koala3005/ESP32Clone_With_I2C_Sensor/24LC1025-I_SM/24LC1025-I_SM.step

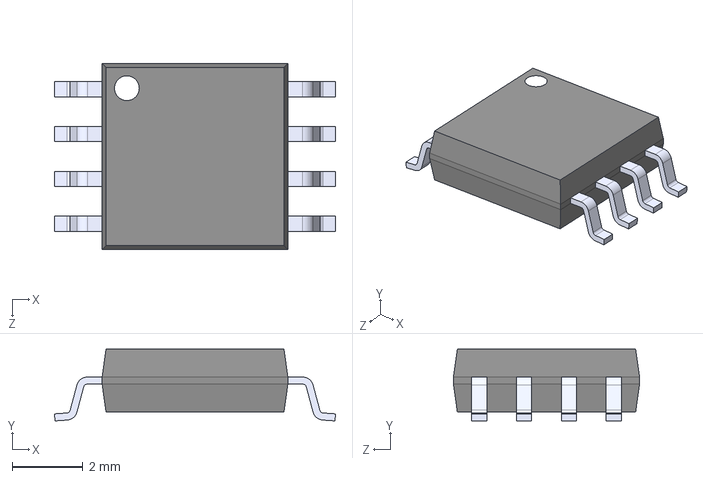
[picture p1: CAD file, 2026-01-12]
24LC1025-I_SM/24LC1025-I_SM.step
7.94 x 2.03 x 5.26 mm
