koala3005/ESP32Clone_With_I2C_Sensor/AHT20/AHT20.step

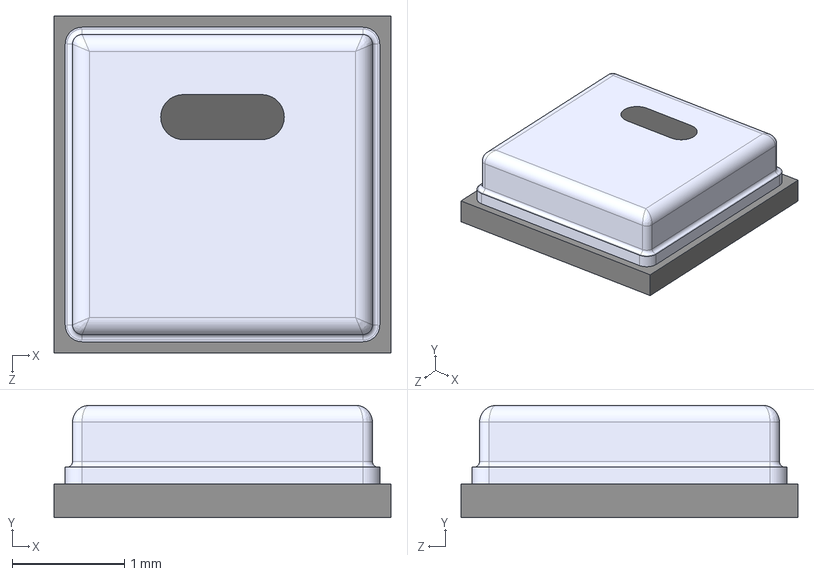
[picture p2: CAD file, 2026-01-12]
AHT20/AHT20.step
3.00 x 1.00 x 3.00 mm
