koala3005/ESP32Clone_With_I2C_Sensor/BH1750FVI-TR/BH1750FVI-TR.step

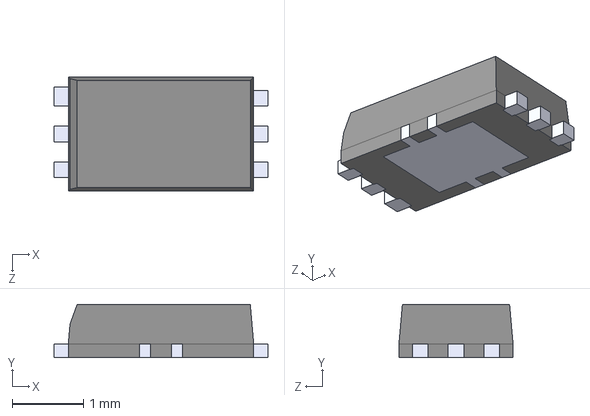
[picture p3: CAD file, 2026-01-12]
BH1750FVI-TR/BH1750FVI-TR.step
3.00 x 0.75 x 1.60 mm
