koala3005/ESP32Clone_With_I2C_Sensor/JLCPCBExtended/SRP4020TA-4R7M.step

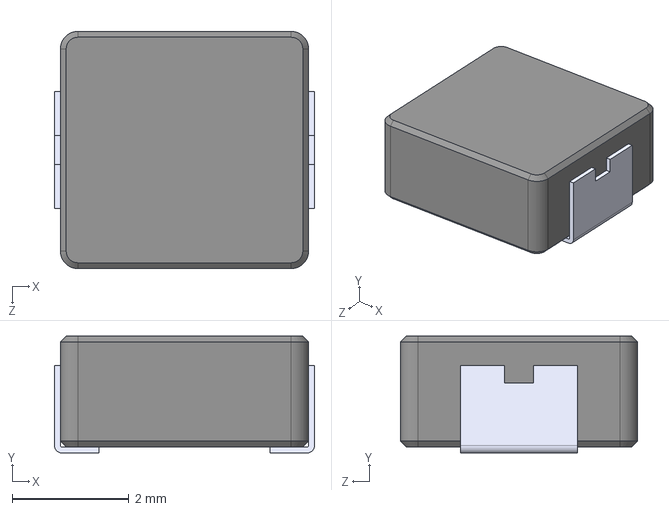
[picture p4: CAD file, 2025-12-17]
JLCPCBExtended/SRP4020TA-4R7M.step
4.45 x 2.00 x 4.06 mm
