koala3005/ESP32Clone_With_I2C_Sensor/JLCPCBExtended/MAL214699103E3.step

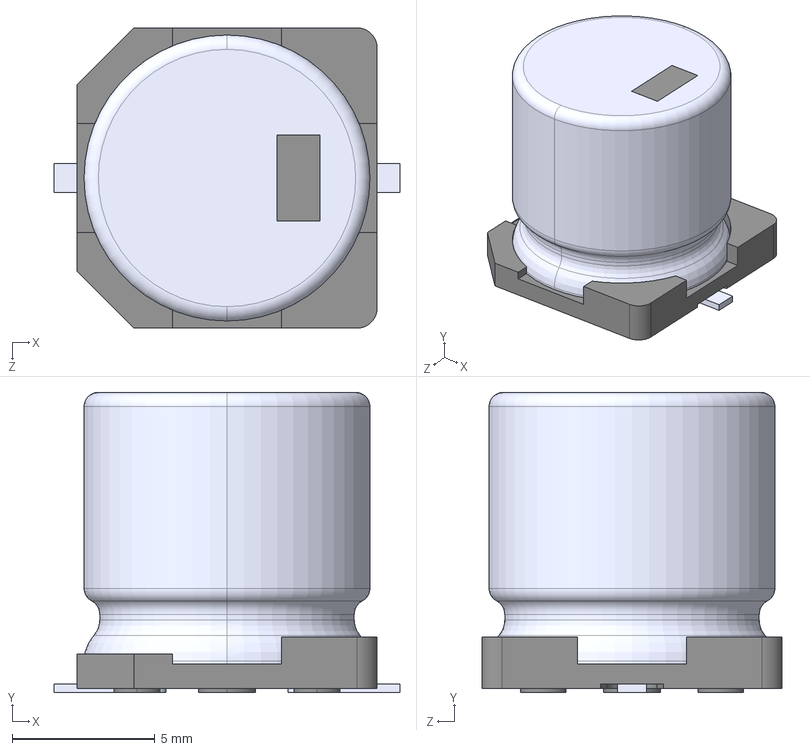
[picture p5: CAD file, 2025-12-17]
JLCPCBExtended/MAL214699103E3.step
12.1 x 10.5 x 10.5 mm
