koala3005/ESP32Clone_With_I2C_Sensor/ESP32Clone/ESP32Clone.kicad_pcb

## KiCad design ESP32Clone/ESP32Clone.kicad_pcb (2026-01-16)

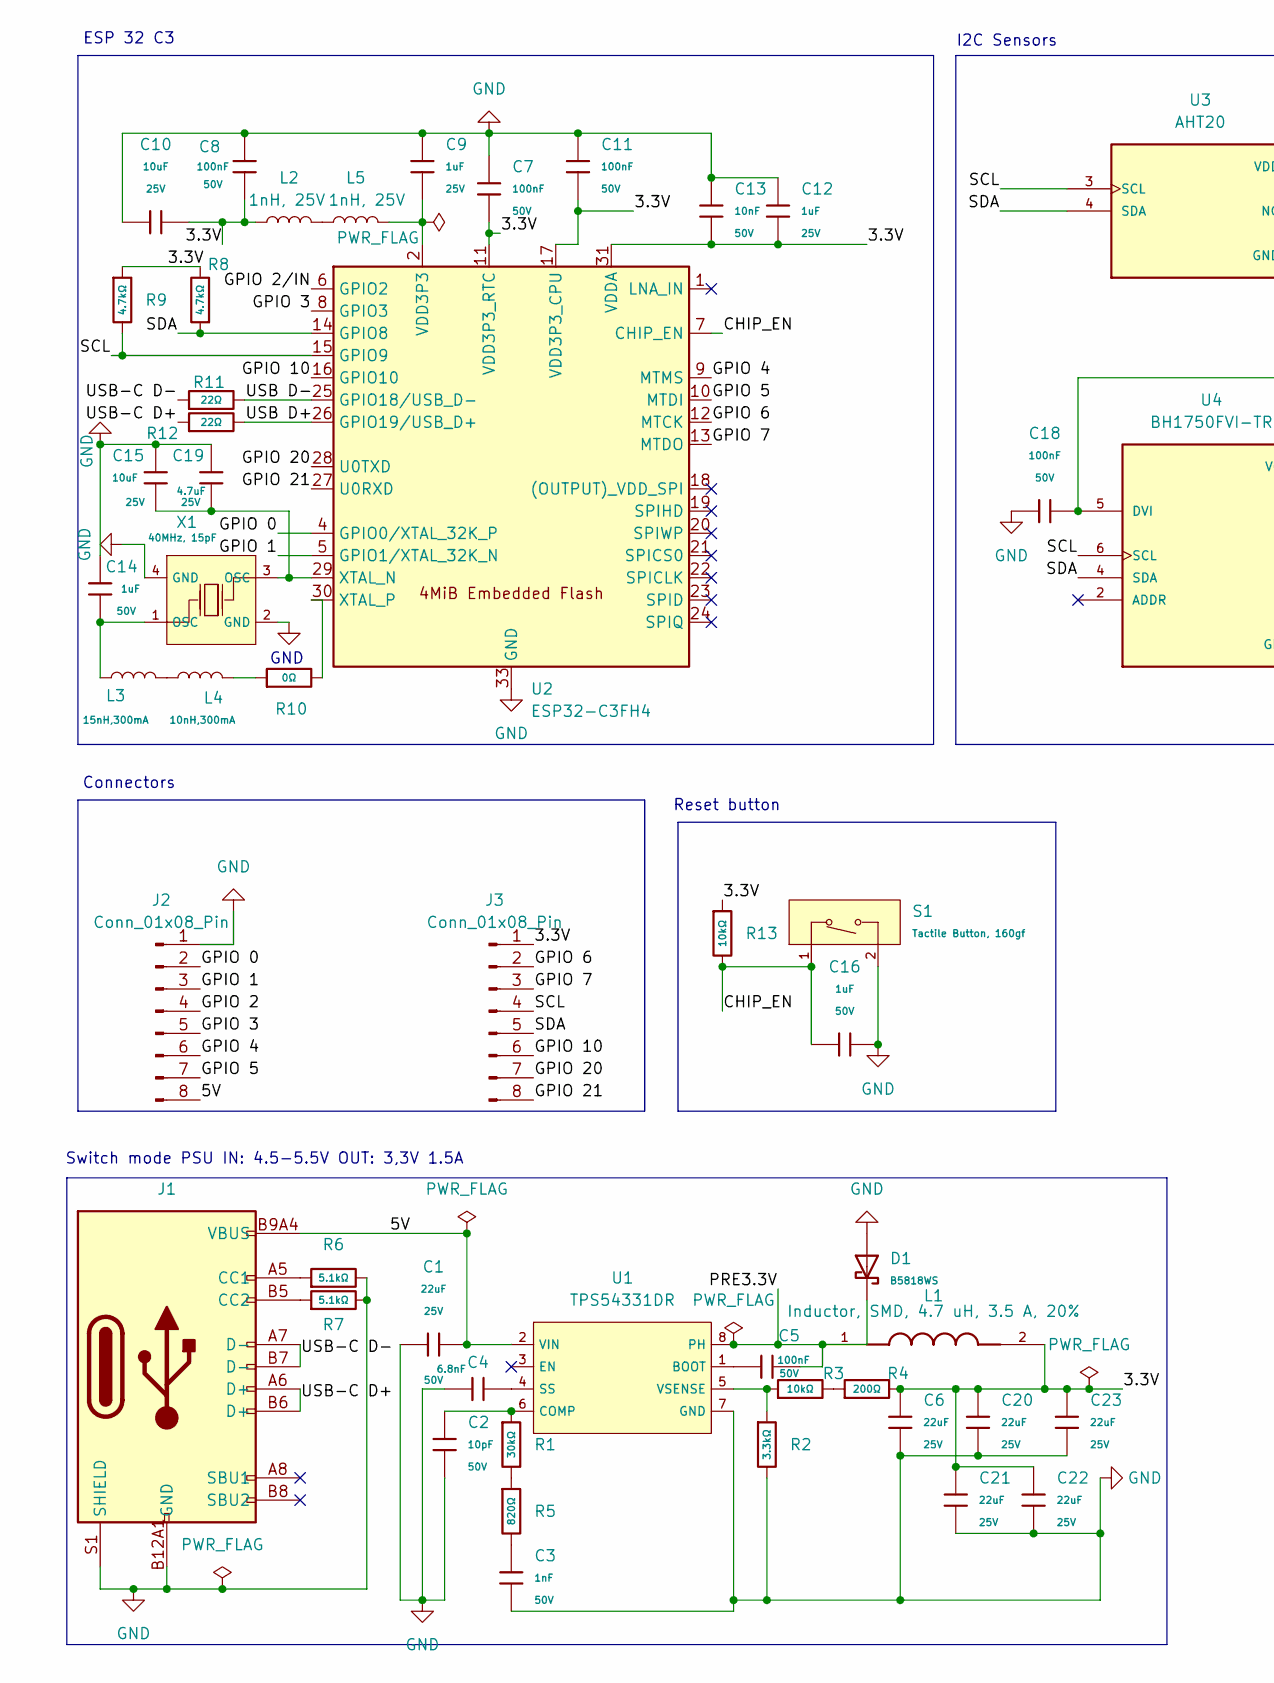
[picture p6: schematic ESP32Clone.kicad_sch, ESP32 clone with I2C humidity, light sensor and eeprom, part in row 1, column 1]

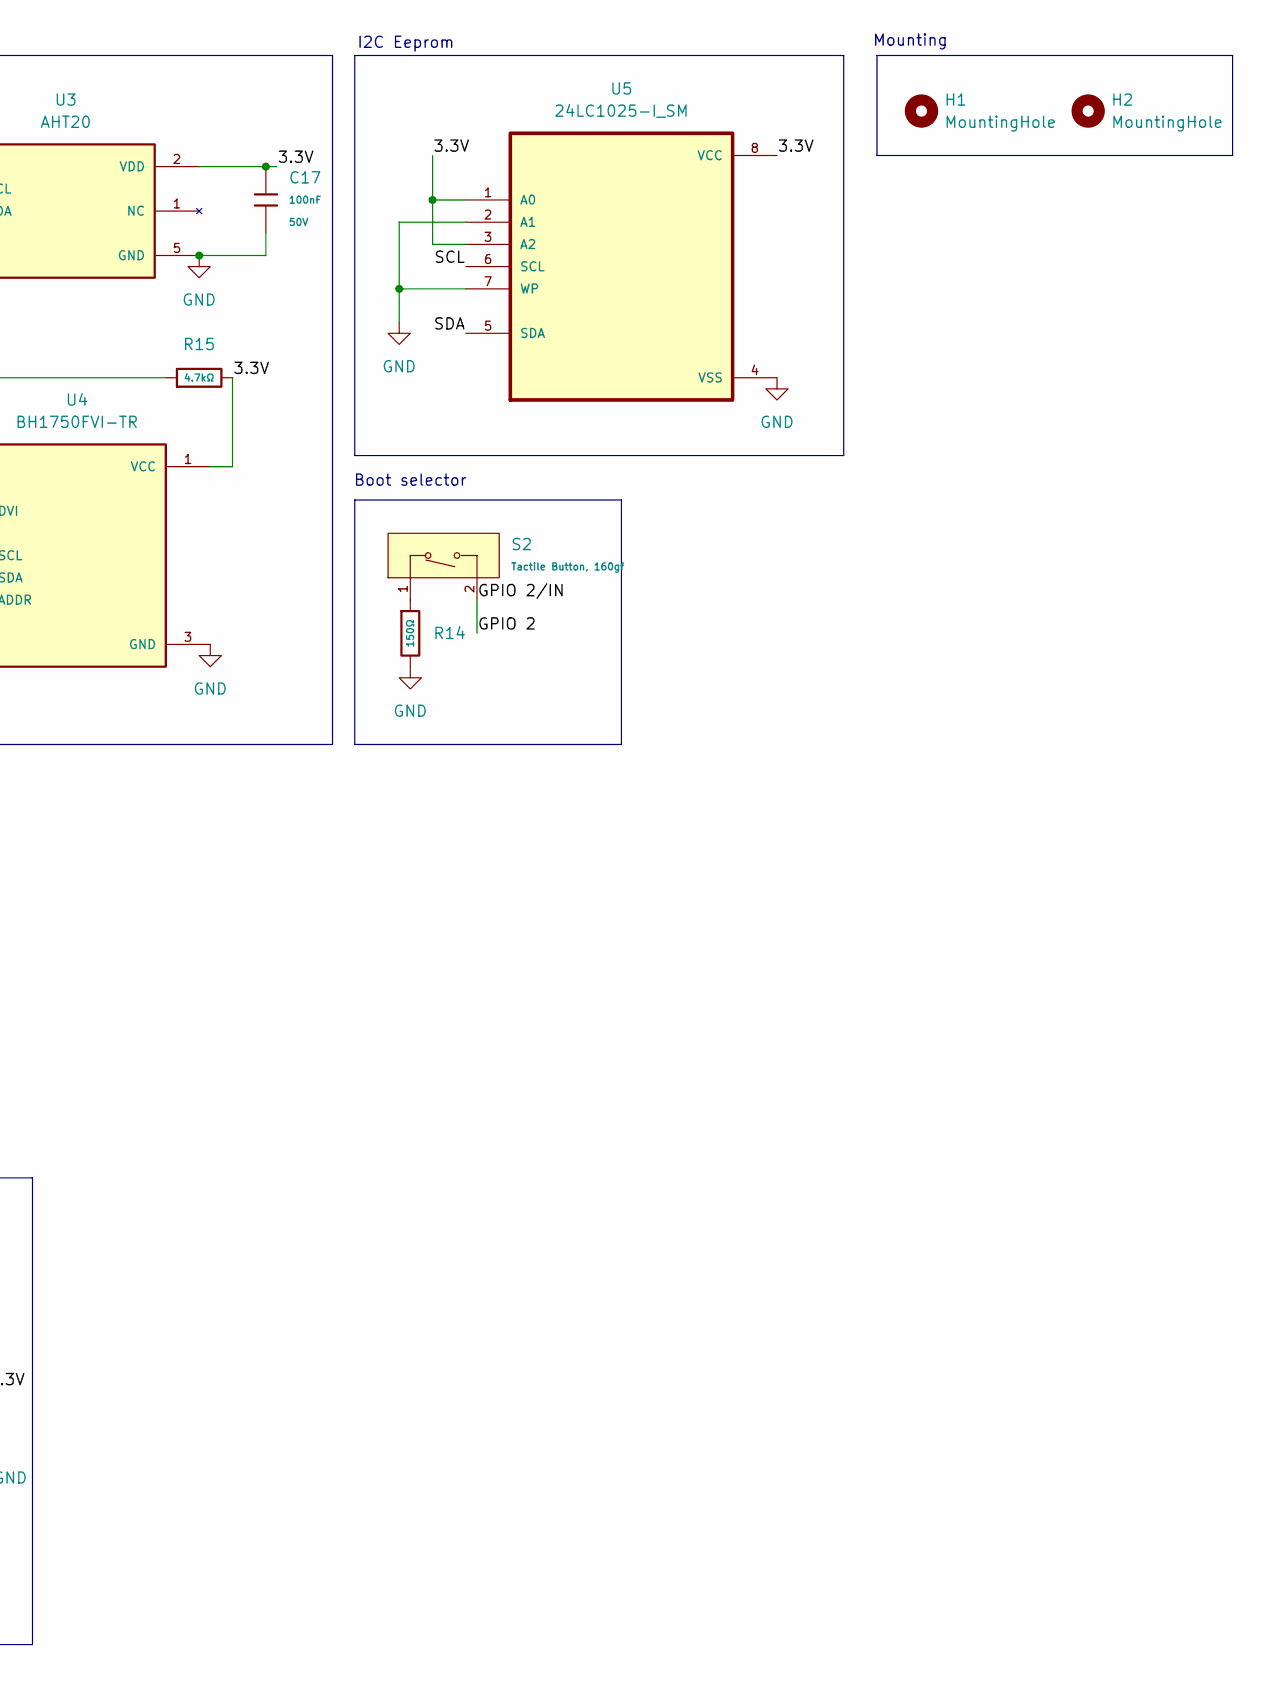
[picture p7: schematic ESP32Clone.kicad_sch, ESP32 clone with I2C humidity, light sensor and eeprom, part in row 1, column 2]

Parts:
C1, C6, C20, C21, C22, C23: 22uF; C_0805; Voltage Rated 25V; Tolerance ±20%; Part CL21A226MAQNNNE; LCSC C45783
C2: 10pF; C_0402; Voltage Rated 50V; Tolerance ±5%; Part CL05C100JB5NNNC; LCSC C32949
C3: 1nF; C_0402; Voltage Rated 50V; Tolerance ±10%; Part 0402B102K500NT; LCSC C1523
C4: 6.8nF; C_0402; Voltage Rated 50V; Tolerance ±10%; Part 0402B682K500NT; LCSC C1542
C5, C7, C8, C11, C17, C18: 100nF; C_0603; Voltage Rated 50V; Tolerance ±10%; Part CC0603KRX7R9BB104; LCSC C14663
C9, C12: 1uF; C_0402; Voltage Rated 25V; Tolerance ±10%; Part CL05A105KA5NQNC; LCSC C52923
C10, C15: 10uF; C_0603; Voltage Rated 25V; Tolerance ±20%; Part CL10A106MA8NRNC; LCSC C96446
C13: 10nF; C_0402; Voltage Rated 50V; Tolerance ±10%; Part CL05B103KB5NNNC; LCSC C15195
C14, C16: 1uF; C_0603; Voltage Rated 50V; Tolerance ±10%; Part CL10A105KB8NNNC; LCSC C15849
C19: 4.7uF; C_0805; Voltage Rated 25V; Tolerance ±10%; Part CL21A475KAQNNNE; LCSC C1779
D1: B5818WS; D_SOD-323; Forward Voltage (Vf@If) 550mV@1A; Reverse Voltage (Vr) 30V; Part B5818WS; LCSC C22466361
H1, H2: MountingHole; MountingHole_2.1mm
J1: Connector, USB-TYPE-C-16P; TYPE-C-SMD_HX-TYPE-C-16PIN; Part USB-TYPE-C-019; LCSC C2927039
J2, J3: Conn_01x08_Pin; PinHeader_1x08_P2.54mm_Vertical; Part CS-1109-1X8(L11.5)PA6T; LCSC C18213722
L1: Inductor, SMD, 4.7 uH, 3.5 A, 20%; IND_SRP4020TA-4R7M; Part SRP4020TA-4R7M; LCSC C2041623
L2, L5: 1nH, 25V; L_0603; Part VHF160808H1N0ST; LCSC C1027
L3: 15nH,300mA; L_0402; Tolerance ±5%; Part SDCL1005C15NJTDF; LCSC C27143
L4: 10nH,300mA; L_0402; Tolerance ±5%; Part SDCL1005C10NJTDF; LCSC C27147
R1: 30kΩ; R_0805; Overload Voltage (Max) 150V; Tolerance ±1%; Part 0805W8F3002T5E; LCSC C17621
R2: 3.3kΩ; R_0402; Overload Voltage (Max) 50V; Tolerance ±1%; Part 0402WGF3301TCE; LCSC C25890
R3: 10kΩ; R_0402; Overload Voltage (Max) 50V; Tolerance ±1%; Part 0402WGF1002TCE; LCSC C25744
R4: 200Ω; R_0402; Overload Voltage (Max) 50V; Tolerance ±1%; Part 0402WGF2000TCE; LCSC C25087
R5: 820Ω; R_0805; Overload Voltage (Max) 150V; Tolerance ±1%; Part 0805W8F8200T5E; LCSC C17837
R6, R7: 5.1kΩ; R_0805; Overload Voltage (Max) 150V; Tolerance ±1%; Part 0805W8F5101T5E; LCSC C27834
R8, R9, R15: 4.7kΩ; R_0805; Overload Voltage (Max) 150V; Tolerance ±1%; Part 0805W8F4701T5E; LCSC C17673
R10: 0Ω; R_0805; Overload Voltage (Max) 150V; Tolerance ±1%; Part 0805W8F0000T5E; LCSC C17477
R11, R12: 22Ω; R_0805; Overload Voltage (Max) 150V; Tolerance ±1%; Part 0805W8F220JT5E; LCSC C17561
R13: 10kΩ; R_0603; Overload Voltage (Max) 75V; Tolerance ±1%; Part 0603WAF1002T5E; LCSC C25804
R14: 150Ω; R_0805; Overload Voltage (Max) 150V; Tolerance ±1%; Part 0805W8F1500T5E; LCSC C17471
S1, S2: Tactile Button, 160gf; SW_TS-1088-AR02016; Voltage Rating (Dc) 12V; Part TS-1088-AR02016; LCSC C720477
U1: TPS54331DR; SOIC-8_L5.0-W4.0-P1.27-LS6.0-BL; Output Voltage 0.8V~25V; Input Voltage 3.5V~28V; Part TPS54331DR; LCSC C9865
U2: ESP32-C3FH4; QFN-32-1EP_5x5mm_P0.5mm_EP3.7x3.7mm_ThermalVias; Part ESP32-C3FH4; LCSC C2858491
U3: AHT20; PSON100P300X300X110-6N; PARTREV V1.0; LCSC C2757850
U4: BH1750FVI-TR; XDCR_BH1750FVI-TR; PARTREV D; LCSC C78960
U5: 24LC1025-I_SM; SOIC127P794X202-8N; Part 24LC1025-I/SM; DigiKey_Part_Number 24LC1025-I/SM-ND
X1: 40MHz, 15pF; OSC-SMD_4P-L3.2-W2.5-BL_SIT8008BI; PartID X322540MPB4SI; LCSC C9010

Connections:
/3.3V: C6.1, C7.2, C8.2, C10.2, C11.2, C12.1, C13.2, C17.1, C20.1, C21.1, C22.1, C23.1, J3.1, L1.2, L2.1, R4.2, R8.2, R9.1, R13.1, R15.2, U2.11 (VDD3P3_RTC), U2.17 (VDD3P3_CPU), U2.31 (VDDA), U2.32 (VDDA), U3.2 (VDD), U4.1 (VCC), U5.1 (A0), U5.3 (A2), U5.8 (VCC)
/5V: C1.2, J1.A9B4 (VBUS), J1.B9A4 (VBUS), J2.8, U1.2 (VIN)
/CHIP_EN: C16.1, R13.2, S1.1 (A), U2.7 (CHIP_EN)
/GPIO 0: J2.2, U2.4 (GPIO0/XTAL_32K_P)
/GPIO 1: J2.3, U2.5 (GPIO1/XTAL_32K_N)
/GPIO 2: J2.4, S2.2 (B), U2.6 (GPIO2)
/GPIO 3: J2.5, U2.8 (GPIO3)
/GPIO 4: J2.6, U2.9 (MTMS)
/GPIO 5: J2.7, U2.10 (MTDI)
/GPIO 6: J3.2, U2.12 (MTCK)
/GPIO 7: J3.3, U2.13 (MTDO)
/GPIO 10: J3.6, U2.16 (GPIO10)
/GPIO 20: J3.7, U2.28 (U0TXD)
/GPIO 21: J3.8, U2.27 (U0RXD)
/PRE3.3V: C5.1, D1.1, L1.1, U1.8 (PH)
/SCL: J3.4, R9.2, U2.15 (GPIO9), U3.3 (SCL), U4.6 (SCL), U5.6 (SCL)
/SDA: J3.5, R8.1, U2.14 (GPIO8), U3.4 (SDA), U4.4 (SDA), U5.5 (SDA)
/USB D+: R12.2, U2.26 (GPIO19/USB_D+)
/USB D-: R11.2, U2.25 (GPIO18/USB_D-)
/USB-C D+: J1.A6 (D+), J1.B6 (D+), R12.1
/USB-C D-: J1.A7 (D-), J1.B7 (D-), R11.1
GND: C1.1, C2.2, C3.1, C4.1, C6.2, C7.1, C8.1, C9.1, C10.1, C11.1, C12.2, C13.1, C14.1, C15.1, C16.2, C17.2, C18.1, C19.1, C20.2, C21.2, C22.2, C23.2, D1.2, J1.A12B1 (GND), J1.B12A1 (GND), J1.S1 (SHIELD), J2.1, R2.2, R6.2, R7.2, R14.2, S1.2 (B), U1.7 (GND), U2.33 (GND), U3.5 (GND), U4.3 (GND), U5.2 (A1), U5.4 (VSS), U5.7 (WP), X1.2 (GND), X1.4 (GND)
unnamed: C3.2, R5.2
unnamed: C9.2, L5.2, U2.2 (VDD3P3), U2.3 (VDD3P3)
unnamed: C14.2, L3.1, X1.1 (OSC)
unnamed: J1.A5 (CC1), R6.1
unnamed: J1.B5 (CC2), R7.1
unnamed: L2.2, L5.1
unnamed: L3.2, L4.1
unnamed: L4.2, R10.1
unnamed: R1.2, R5.1
unnamed: R3.2, R4.1
unnamed: R14.1, S2.1 (A)
unnamed: C5.2, U1.1 (BOOT)
unnamed: C2.1, R1.1, U1.6 (COMP)
unnamed: C4.2, U1.4 (SS)
unnamed: R2.1, R3.1, U1.5 (VSENSE)
unnamed: C15.2, C19.2, U2.29 (XTAL_N), X1.3 (OSC)
unnamed: R10.2, U2.30 (XTAL_P)
unnamed: C18.2, R15.1, U4.5 (DVI)

Notes on the sheet:
Mounting
Switch mode PSU IN: 4.5-5.5V OUT: 3,3V 1.5A
I2C Eeprom
I2C Sensors
Reset button
GND
ESP 32 C3
Boot selector
Connectors

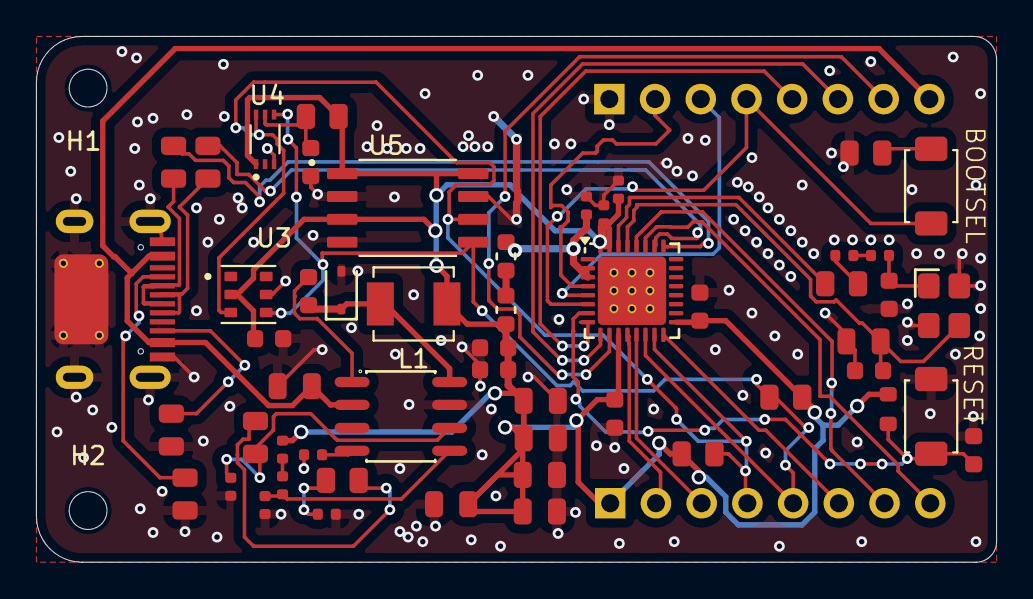
[picture p8: board ESP32Clone.kicad_pcb from above]

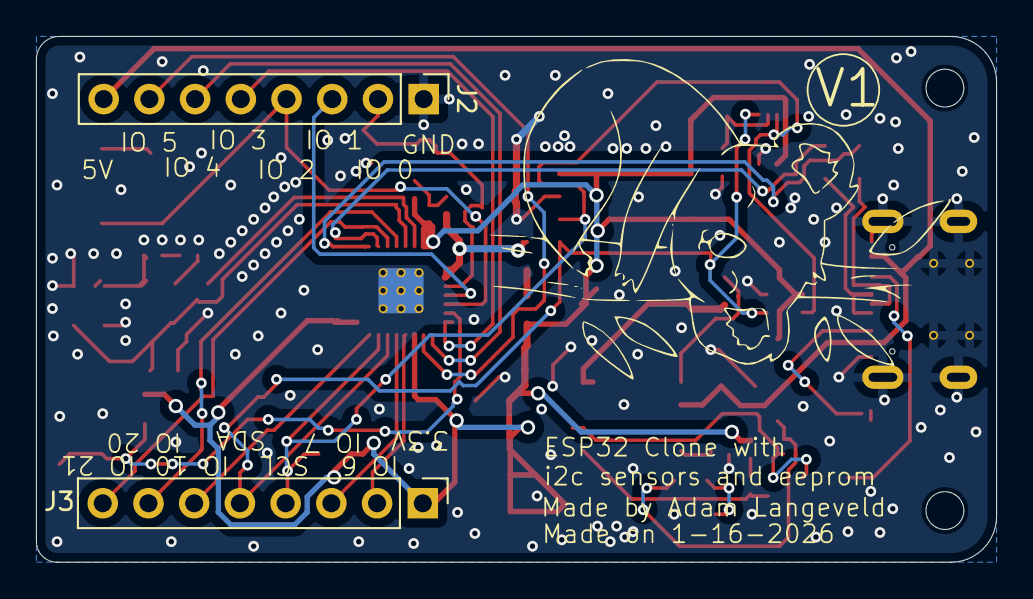
[picture p9: board ESP32Clone.kicad_pcb from below]

Board: 2 copper layers, 53.3 x 29.2 mm, 57 parts (2 on the bottom side), 40 nets.
