koala3005/ESP32Clone_With_I2C_Sensor/(commit log)

2025-12-17 PSU and USB-C port added
    [ESP32Clone.kicad_pcb, ESP32Clone.kicad_sch, MAL214699103E3.step, SRP4020TA-4R7M.step]
2025-12-17 connected configuration pins
    [ESP32Clone.kicad_sch]
2025-12-17 ESP 32 added
    [ESP32Clone.kicad_sch]
2025-12-29 Finished esp32
2025-12-29 Added connecter and reset switch
2025-12-29 Further work on connectors
    [ESP32Clone.kicad_sch]
2026-01-01 Added IC2 devices
    [ESP32Clone.kicad_sch]
2026-01-01 Changed text color
    [ESP32Clone.kicad_sch]
2026-01-01 Added footprints
    [ESP32Clone.kicad_sch]
2026-01-01 Resolved ERC issue's and filled in sheet info
    Warning's remaining:
    Current configuration does not include symbol library 'Connector'.
    Is just a warning because of the configuration i have where only custom and JLCPCB libraries are on
    Pin with no connection type is connected.
    This pin is connected to a no connect flag, feel like that should'nt give a warning
2026-01-01 Autosave and backup
    [ESP32Clone.kicad_sch]
2026-01-05 The thing i said before forgot to save
    [ESP32Clone.kicad_sch]
2026-01-05 Fixed footprint
    [ESP32Clone.kicad_sch]
2026-01-05 Replaced capictor
    [ESP32Clone.kicad_sch]
2026-01-05 PCB started
    [ESP32Clone.kicad_pcb, ESP32Clone.kicad_sch]
2026-01-06 Done DRC
    only has a few library issue's left
    [ESP32Clone.kicad_pcb, ESP32Clone.kicad_sch]
2026-01-08 added silkscreen
    [ESP32Clone.kicad_pcb, ESP32Clone.kicad_sch]
2026-01-08 added funny koala
    [ESP32Clone.kicad_pcb]
2026-01-12 cleaned up files
    [ESP32Clone.kicad_pcb]
2026-01-12 moved footprint files into the git directory
    [24LC1025-I_SM.step, AHT20.step, BH1750FVI-TR.step]
2026-01-12 Added last few 3D files
    [ESP32Clone.kicad_sch]
2026-01-14 Added mounting holes and fixed erc warnings
    ERC warning remaining:
    Pin no connection type is connected, its connected to a no connect flag somehow thats a warning.
    Both Gpio 2 GPIO 2/IN are connected to the same item. this is correct it has to do with the boot select
    [ESP32Clone.kicad_sch]
2026-01-14 Fixed DRC
    DRC remianing:
    3x Koala figure silkscreen clipped by something,
    the koala is giant and doesnt give importent information so its fine
    [ESP32Clone.kicad_pcb, ESP32Clone.kicad_sch]
2026-01-14 fixed long vsense wire
    [ESP32Clone.kicad_pcb]
2026-01-16 removed a few islands and generated bom
    [ESP32Clone.kicad_pcb, ESP32Clone.kicad_sch]
2026-01-16 generated bom correctly
    [ESP32Clone.csv]
